RoboBoat-HSRW/Rudder-controller-STM32/images/rudder_drawing.jpg

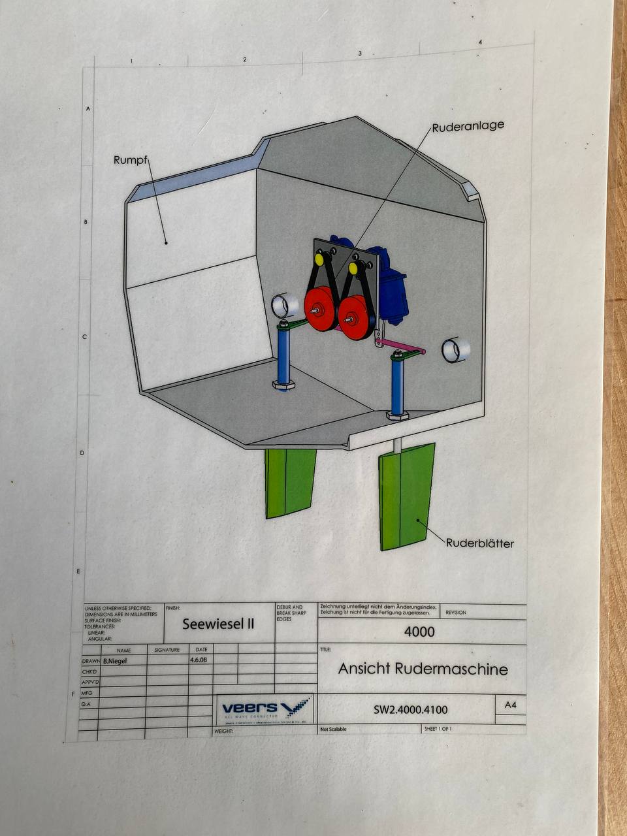
images/rudder_drawing.jpg
