RoboBoat-HSRW/Rudder-controller-STM32/Rudder_stm32f302/Rudder_stm32f302.step

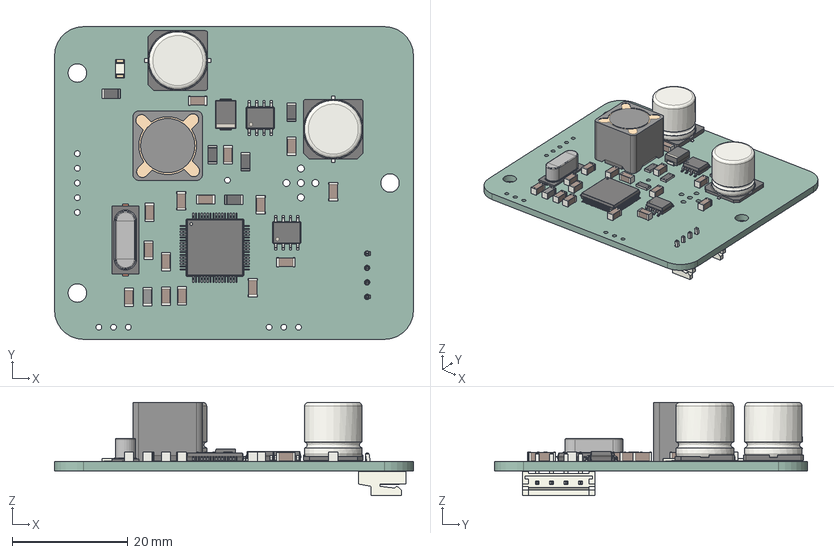
[picture p8: CAD file, 2025-06-30]
Rudder_stm32f302/Rudder_stm32f302.step
62.0 x 54.0 x 16.1 mm
C_1206_3216Metric x 15
D_SMB
C_Elec_10x102 x 2
L_Pulse_PA4320
LQFP_64_10x10mm_P05mm
R_1206_3216Metric x 5
LED_1206_3216Metric
Crystal_SMD_HC49-SD
L_1206_3216Metric
SOIC_8_39x49mm_P127mm x 2
JST_S4B_EH
stm32f103 board_PCB
