RoboBoat-HSRW/Rudder-controller-STM32/Rudder_stm32f302/Rudder_stm32f302.kicad_pcb

## KiCad design Rudder_stm32f302/Rudder_stm32f302.kicad_pcb (2025-06-30)

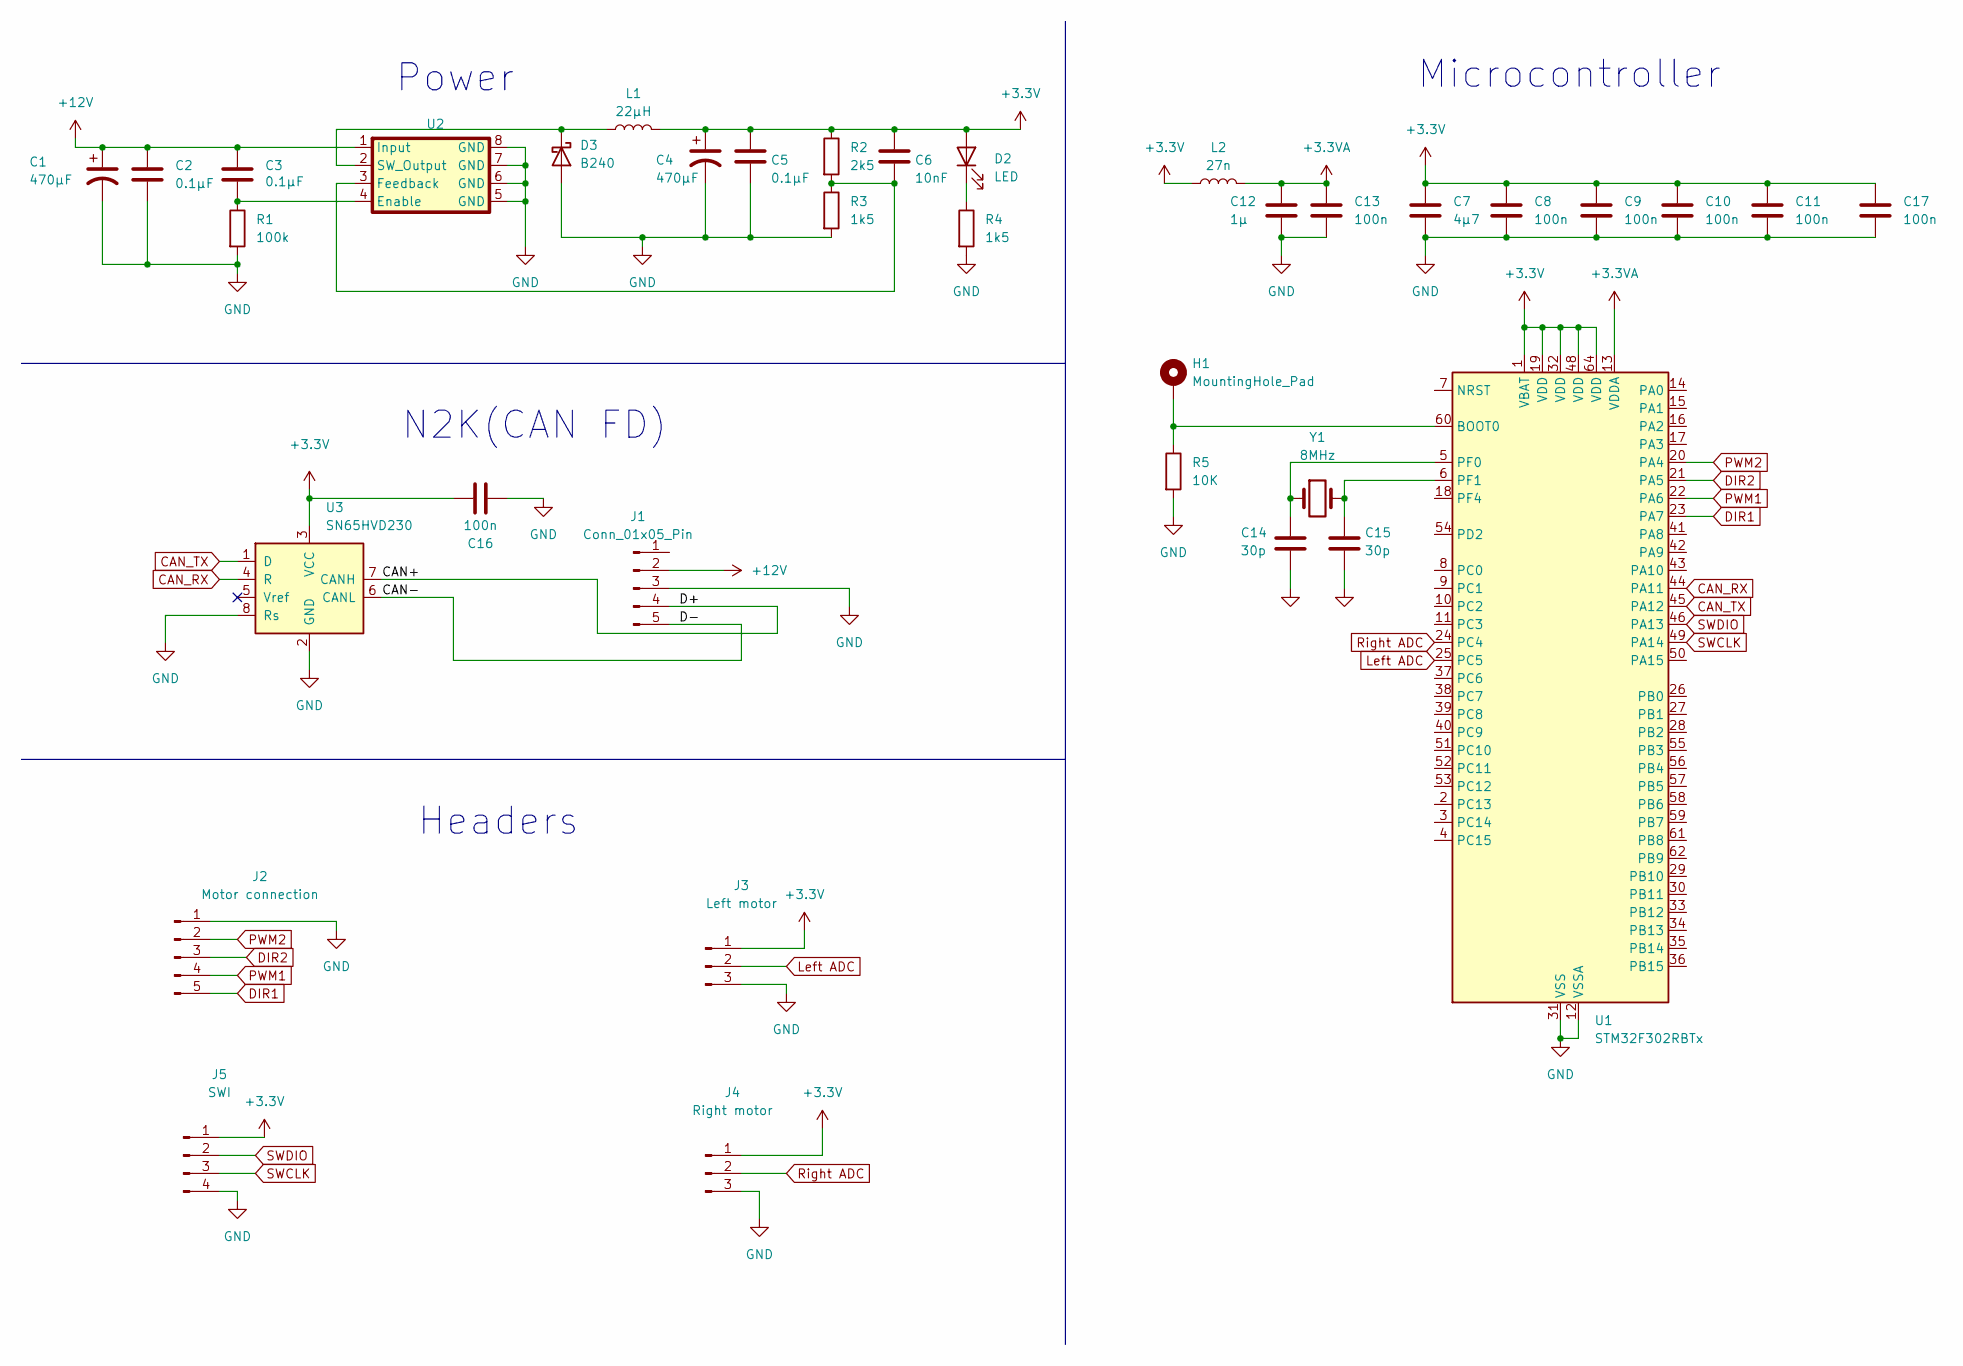
[picture p10: schematic Rudder_stm32f302.kicad_sch]

Parts:
C1, C4: 470µF; C_Elec_10x10.2
C2, C3, C5: 0.1µF; C_1206_3216Metric
C6: 10nF; C_1206_3216Metric
C7: 4µ7; CP_EIA-6032-20_AVX-F_Pad2.25x2.35mm_HandSolder
C8, C9, C10, C11, C13, C16, C17: 100n; C_1206_3216Metric
C12: 1µ; C_1206_3216Metric
C14, C15: 30p; C_1206_3216Metric
D2: LED; LED_1206_3216Metric
D3: B240; D_SMB
H1: MountingHole_Pad; PinHeader_1x01_P2.54mm_Vertical
J1: Conn_01x05_Pin; m12_5pol
J2: Motor connection; PinHeader_1x05_P2.54mm_Vertical
J3: Left motor; PinHeader_1x03_P2.54mm_Vertical
J4: Right motor; PinHeader_1x03_P2.54mm_Vertical
J5: SWI; JST_EH_S4B-EH_1x04_P2.50mm_Horizontal
L1: 22µH; L_Taiyo-Yuden_NR-80xx
L2: 27n; L_1206_3216Metric
R1: 100k; R_1206_3216Metric
R2: 2k5; R_1206_3216Metric
R3, R4: 1k5; R_1206_3216Metric
R5: 10K; R_1206_3216Metric
U1: STM32F302RBTx; LQFP-64_10x10mm_P0.5mm
U2: SOIC-8_3.9x4.9mm_P1.27mm
U3: SN65HVD230; SOIC-8_3.9x4.9mm_P1.27mm
Y1: 8MHz; Crystal_SMD_HC49-SD

Connections:
+3.3V: C4.1, C5.1, C6.1, C7.1, C8.1, C9.1, C10.1, C11.1, C16.1, C17.1, D2.2 (A), J3.1, J4.1, J5.1, L1.2, L2.1, R2.1, U1.1 (VBAT), U1.19 (VDD), U1.32 (VDD), U1.48 (VDD), U1.64 (VDD), U3.3 (VCC)
+3.3VA: C12.1, C13.1, L2.2, U1.13 (VDDA)
+12V: C1.1, C2.1, C3.1, J1.2, U2.1 (Input)
/CAN+: J1.4, U3.7 (CANH)
/CAN-: J1.5, U3.6 (CANL)
CAN_RX: U1.44 (PA11), U3.4 (R)
CAN_TX: U1.45 (PA12), U3.1 (D)
DIR1: J2.5, U1.23 (PA7)
DIR2: J2.3, U1.21 (PA5)
GND: C1.2, C2.2, C4.2, C5.2, C7.2, C8.2, C9.2, C10.2, C11.2, C12.2, C13.2, C14.2, C15.2, C16.2, C17.2, D3.2 (A), J1.3, J2.1, J3.3, J4.3, J5.4, R1.2, R3.2, R4.2, R5.2, U1.12 (VSSA), U1.31 (VSS), U1.47 (VSS), U1.63 (VSS), U2.5 (GND), U2.6 (GND), U2.7 (GND), U2.8 (GND), U3.2 (GND), U3.8 (Rs)
Left ADC: J3.2, U1.25 (PC5)
unnamed: D2.1 (K), R4.1
unnamed: D3.1 (K), L1.1, U2.2 (SW_Output)
unnamed: H1.1, R5.1, U1.60 (BOOT0)
unnamed: C14.1, U1.5 (PF0), Y1.1
unnamed: C15.1, U1.6 (PF1), Y1.2
unnamed: C3.2, R1.1, U2.4 (Enable)
unnamed: C6.2, R2.2, R3.1, U2.3 (Feedback)
PWM1: J2.4, U1.22 (PA6)
PWM2: J2.2, U1.20 (PA4)
Right ADC: J4.2, U1.24 (PC4)
SWCLK: J5.3, U1.49 (PA14)
SWDIO: J5.2, U1.46 (PA13)

Notes on the sheet:
Power
Microcontroller
N2K(CAN FD)
Headers

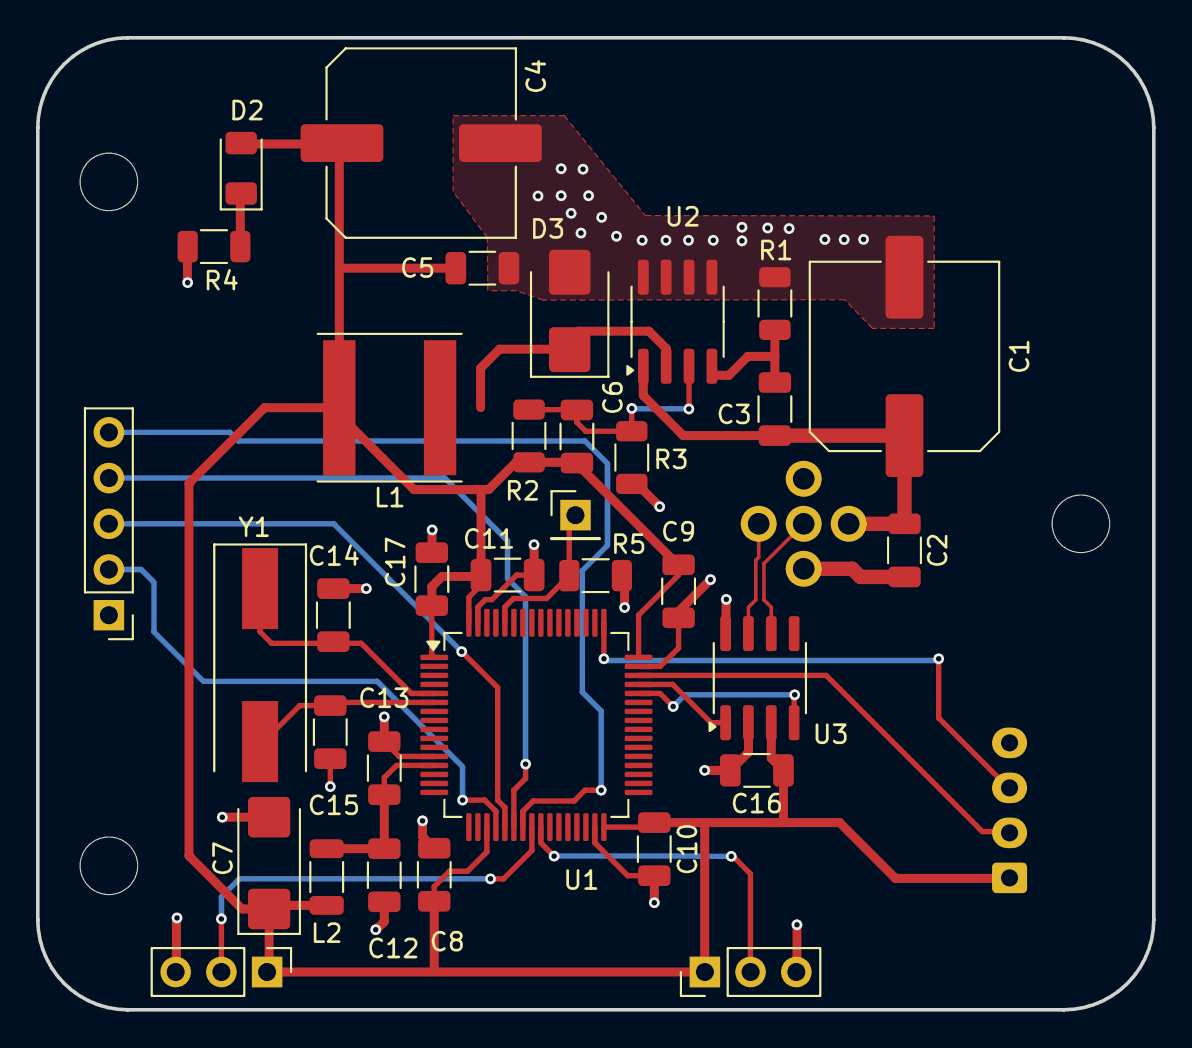
[picture p11: board Rudder_stm32f302.kicad_pcb from above]

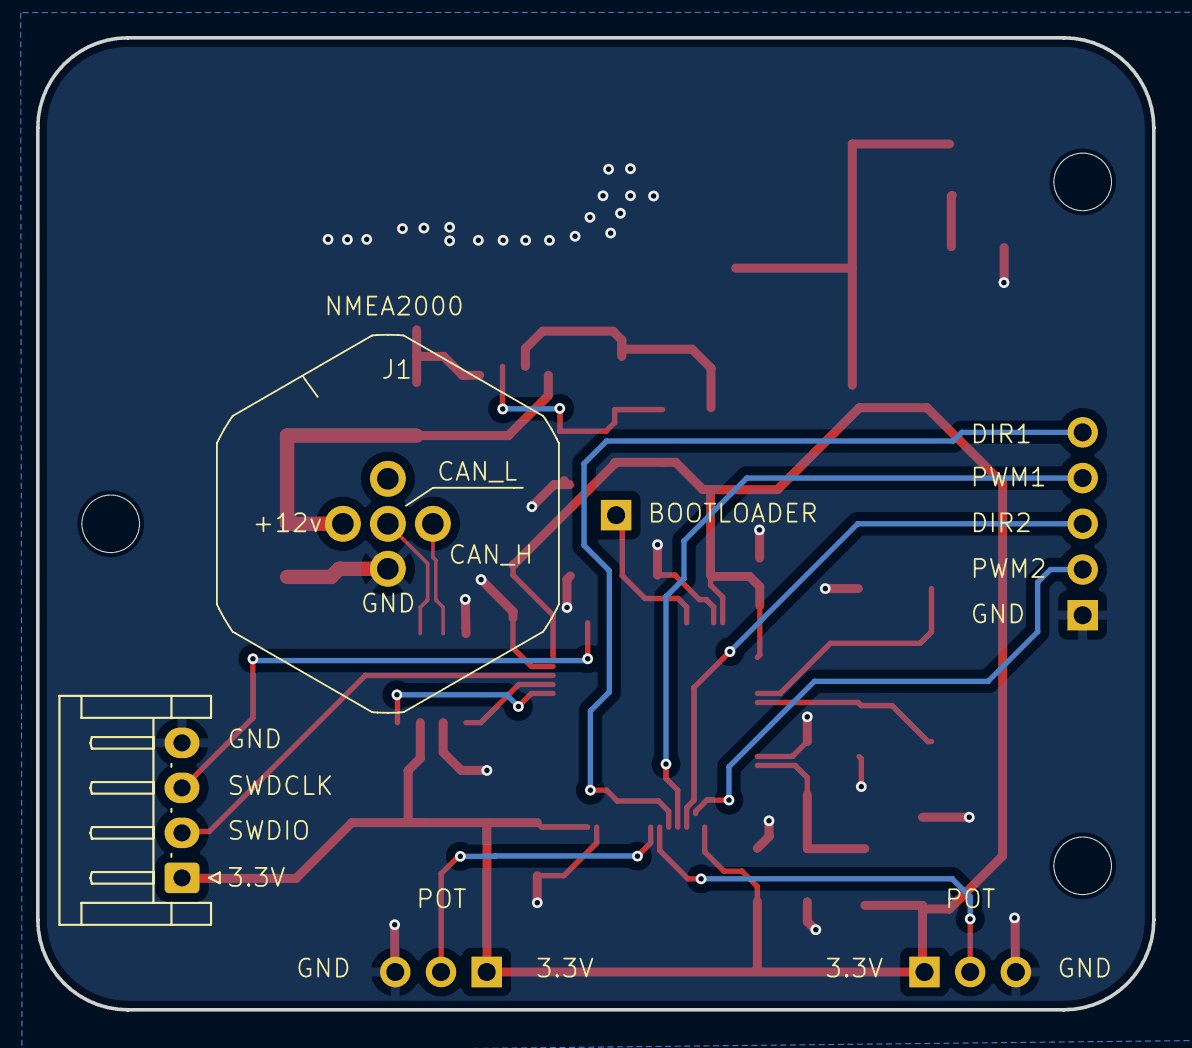
[picture p12: board Rudder_stm32f302.kicad_pcb from below]

Board: 2 copper layers, 62.0 x 54.0 mm, 36 parts (2 on the bottom side), 23 nets.
