RoboBoat-HSRW/Rudder-controller-STM32/Core/Src/main.cpp

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
/* Includes ------------------------------------------------------------------*/
#include "main.h"
#include "adc.h"
#include "can.h"
#include "dma.h"
#include "tim.h"
#include "gpio.h"
#include "motor.h"
#include "pid.h"
#include "stm32f3xx_hal_adc.h"
#include "stm32f3xx_hal.h"


/* USER CODE BEGIN PV */
  uint8_t adc_ready = 0;
  uint16_t CanMessage[2] = {0};
  Motor motor_left(GPIOA, GPIO_PIN_4, // DIR pin
		  &(TIM2->CCR1), 			  // PWM output
		  &adc_value[0], 740, 240,    // Pot input, max, min
		  &CanMessage[0], 			      // Set Point
		  5.0, 0.0, 0.0);			  // PID

  Motor motor_right(GPIOA, GPIO_PIN_6, // DIR pin
  		  &(TIM1->CCR1), 			  // PWM output
  		  &adc_value[1], 740, 240,    // Pot input, max, min
  		  &CanMessage[0], 			      // Set Point
  		  5.0, 0.0, 0.0);			  // PID
/* USER CODE END PV */

void SystemClock_Config(void);
/**
  * @brief  The application entry point.
  * @retval int
  */
int main(void)
{

  /* MCU Configuration--------------------------------------------------------*/

  /* Reset of all peripherals, Initializes the Flash interface and the Systick. */
  HAL_Init();

  /* Configure the system clock */
  SystemClock_Config();

  /* Initialize all configured peripherals */
  MX_GPIO_Init();
  MX_DMA_Init();
  MX_CAN_Init();
  MX_TIM1_Init();
  MX_TIM2_Init();
  MX_ADC2_Init();
  /* Infinite loop */
  /* USER CODE BEGIN WHILE */
  while (1)
  {
    /* USER CODE END WHILE */

	 // motor_left.controlLoop();
	  //motor_right.controlLoop();
    /* USER CODE BEGIN 3 */
  }
  /* USER CODE END 3 */
}

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
