RoboBoat-HSRW/Rudder-controller-STM32/RudderControl.ioc

Mcu.UserName=STM32F302RBTx
PA11.Signal=CAN_RX
PA12.Signal=CAN_TX
PA13.Signal=SYS_JTMS-SWDIO
PA14.Signal=SYS_JTCK-SWCLK
PA4.GPIO_Label=DIR1
PA4.Signal=GPIO_Output
PA5.GPIO_Label=PWM1
PA5.Signal=S_TIM2_CH1_ETR
PA6.GPIO_Label=DIR2
PA6.Signal=GPIO_Output
PA7.GPIO_Label=PWM2
PA7.Signal=TIM1_CH1N
PC4.Signal=ADC2_IN5
PC5.Signal=ADC2_IN11
PF0-OSC_IN.GPIO_Label=XTAL1
PF0-OSC_IN.Signal=RCC_OSC_IN
PF1-OSC_OUT.GPIO_Label=XTAL2
PF1-OSC_OUT.Signal=RCC_OSC_OUT
