RoboBoat-HSRW/Rudder-controller-STM32/Core/Inc/main.h

#define XTAL1_Pin GPIO_PIN_0
#define XTAL1_GPIO_Port GPIOF
#define XTAL2_Pin GPIO_PIN_1
#define XTAL2_GPIO_Port GPIOF
#define DIR1_Pin GPIO_PIN_4
#define DIR1_GPIO_Port GPIOA
#define PWM1_Pin GPIO_PIN_5
#define PWM1_GPIO_Port GPIOA
#define DIR2_Pin GPIO_PIN_6
#define DIR2_GPIO_Port GPIOA
#define PWM2_Pin GPIO_PIN_7
#define PWM2_GPIO_Port GPIOA
